josephmarlin/Feline-Sustenance-Amplifier/CatFeeder.pdf

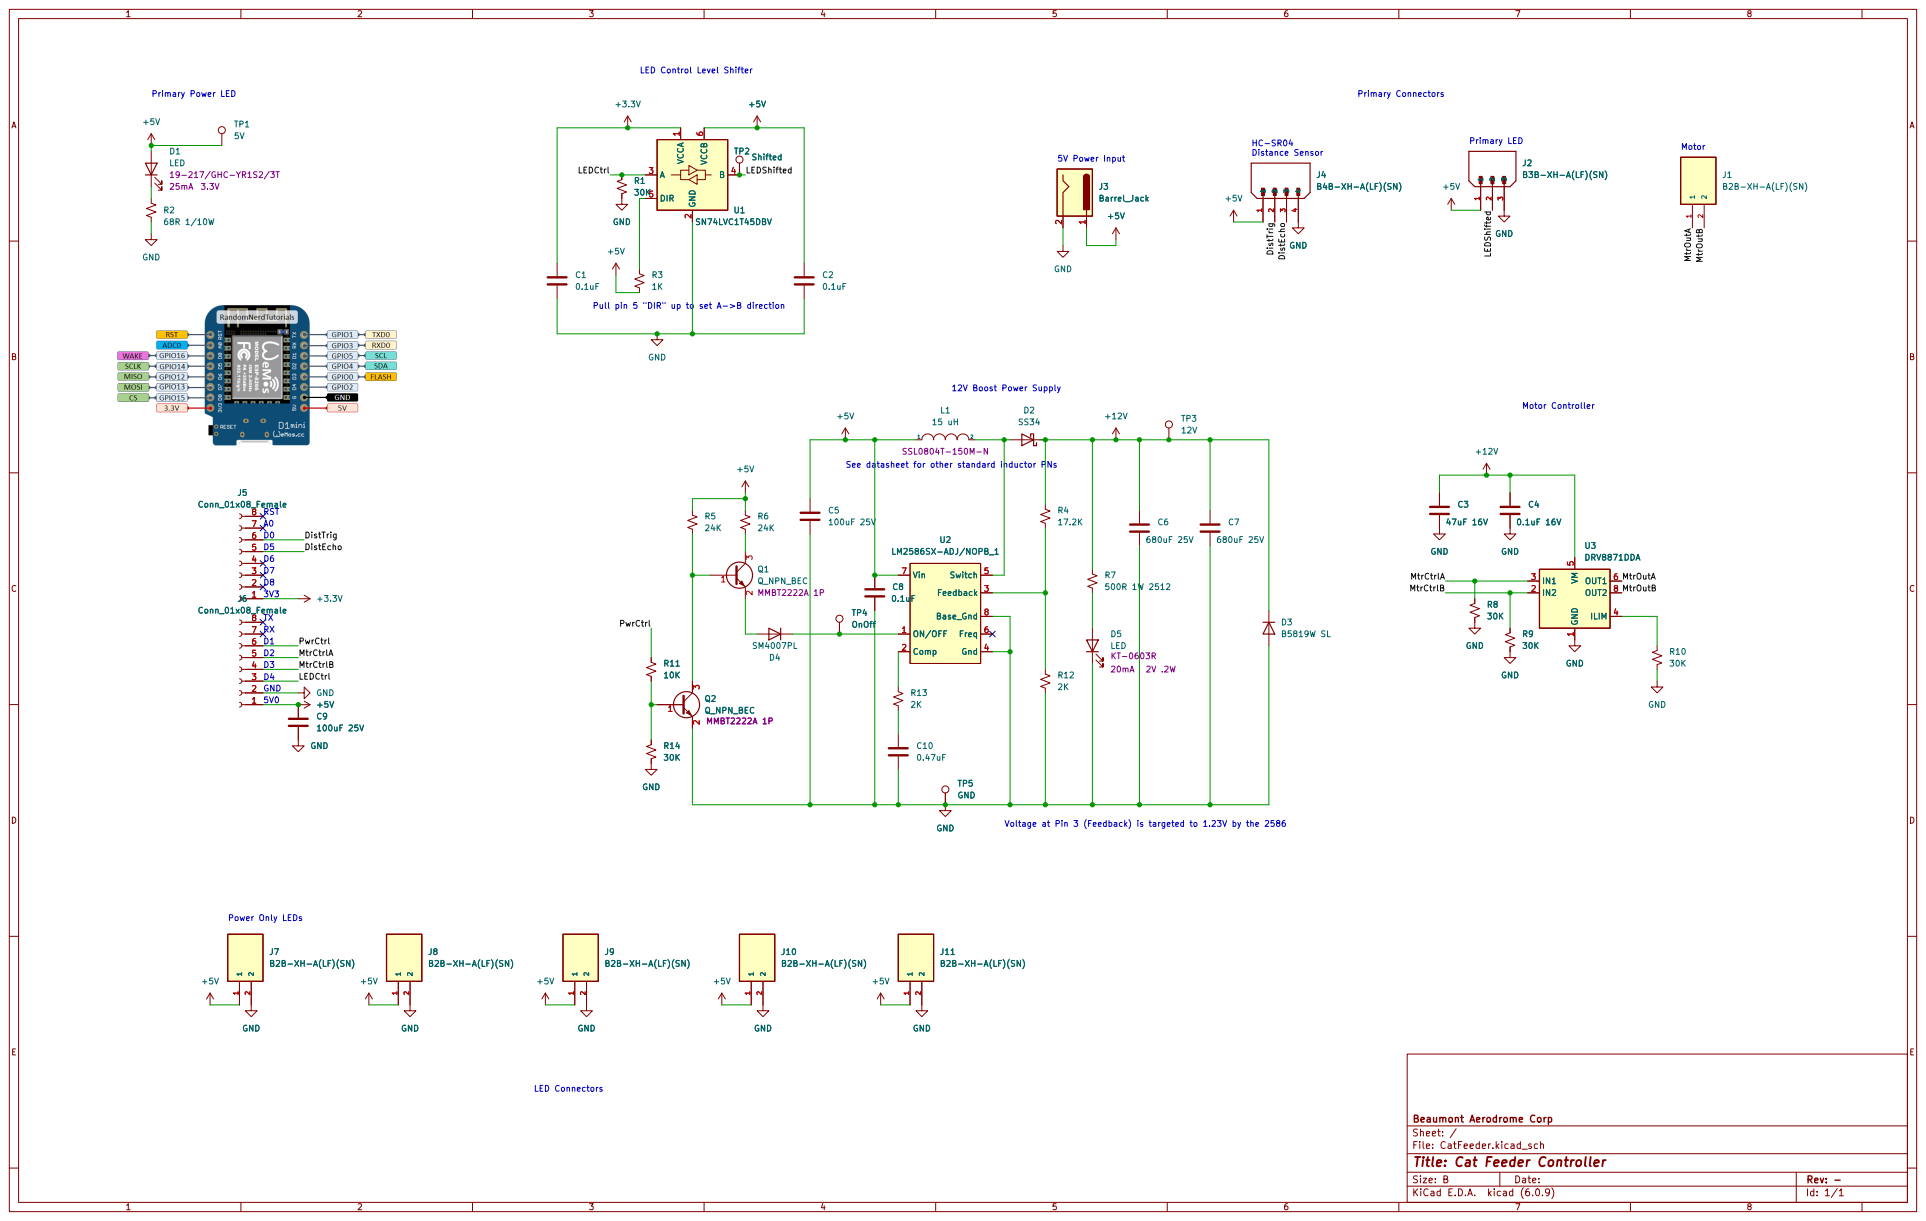
[picture p1: page 1]

Pull pin 5 "DIR" up to set A->B direction

2 J8B2B-XH-A(LF)(SN) D3B5819W SL GND GND

2 J11B2B-XH-A(LF)(SN) GND

Voltage at Pin 3 (Feedback) is targeted to 1.23V by the 2586

LED Connectors Power Only LEDs

File: CatFeeder.kicad_sch Sheet: / Beaumont Aerodrome Corp

Id: 1/1 Title: Cat Feeder Controller
