josephmarlin/Feline-Sustenance-Amplifier/CatFeeder.kicad_pcb

## KiCad design CatFeeder.kicad_pcb (2023-03-10)

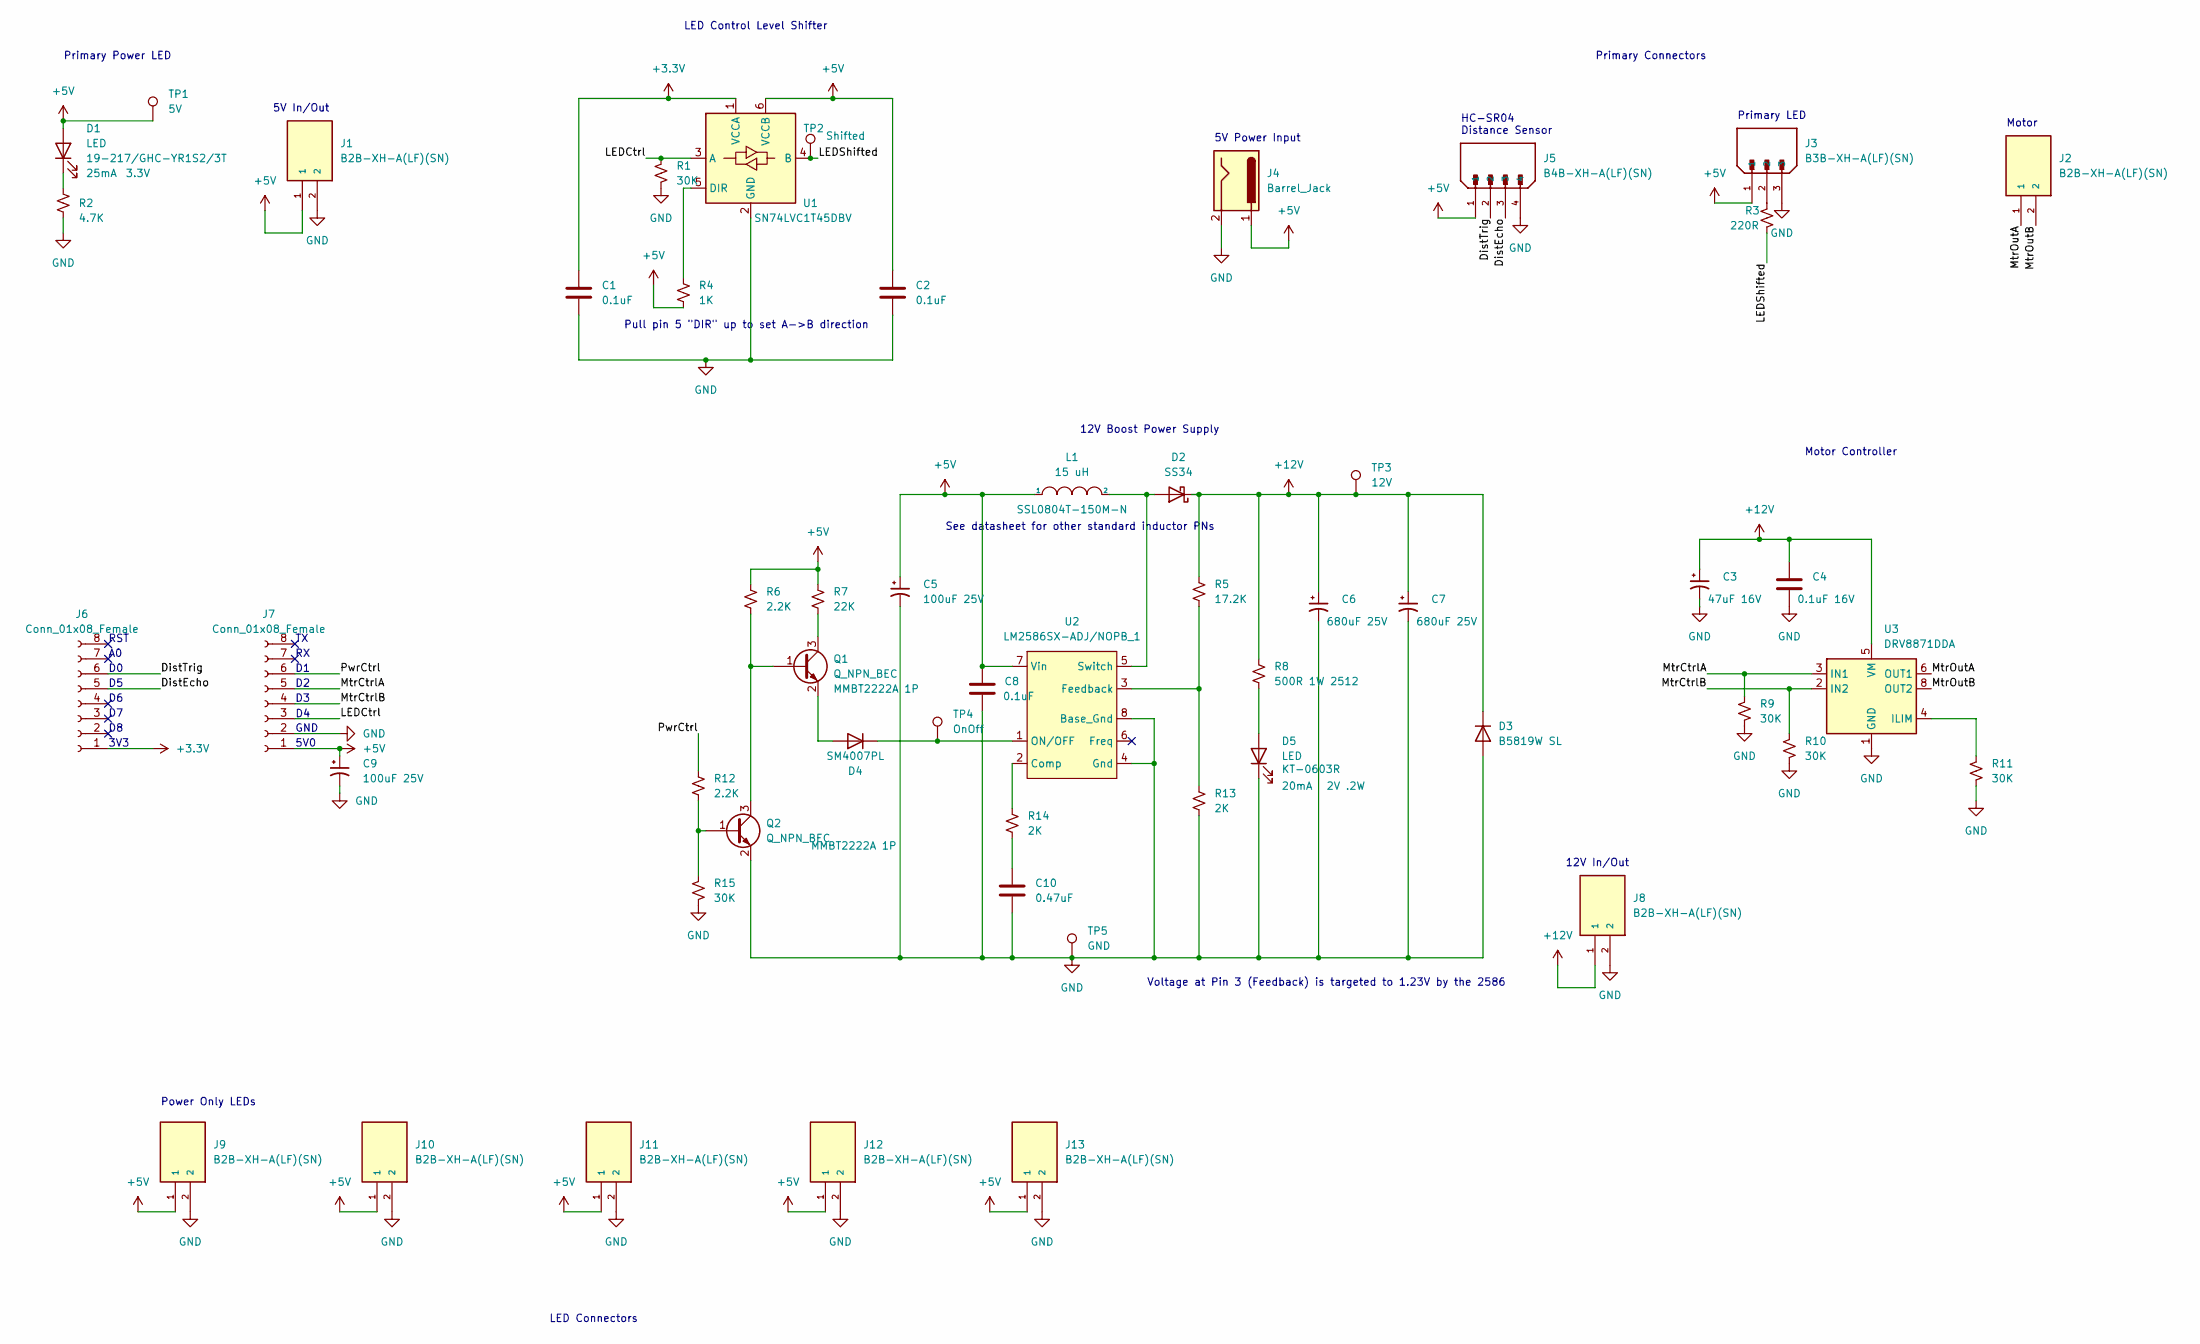
[picture p2: schematic CatFeeder.kicad_sch, Cat Feeder Controller]

Parts:
C1, C2, C8: 0.1uF; C_0402_1005Metric
C3: 47uF 16V; CP_Elec_5x5.4
C4: 0.1uF 16V; C_0402_1005Metric
C5, C9: 100uF 25V; CP_Radial_D8.0mm_P3.50mm
C6, C7: 680uF 25V; CP_Radial_D8.0mm_P3.50mm
C10: 0.47uF; C_0603_1608Metric
D1: LED; LED_0603_1608Metric; Voltage 3.3V
D2: SS34; D_SMA
D3: B5819W SL; D_SOD-123
D4: SM4007PL; D_SOD-123F
D5: LED; LED_0603_1608Metric; Voltage 2V .2W
J1, J2, J8, J9, J10, J11, J12, J13: B2B-XH-A(LF)(SN); JST_XH_B2B-XH-A_1x02_P2.50mm_Vertical
J3: B3B-XH-A(LF)(SN); JST_XH_B3B-XH-A_1x03_P2.50mm_Vertical; PARTREV N/A
J4: Barrel_Jack; BarrelJack_CUI_PJ-063AH_Horizontal
J5: B4B-XH-A(LF)(SN); JST_XH_B4B-XH-A_1x04_P2.50mm_Vertical; PARTREV N/A
J6, J7: Conn_01x08_Female; PinSocket_1x08_P2.54mm_Vertical
L1: 15 uH; SSL0804_Inductor_SMD
Q1, Q2: Q_NPN_BEC; SOT-23
R1, R9, R10, R11, R15: 30K; R_0402_1005Metric
R2: 4.7K; R_0805_2012Metric
R3: 220R; R_0805_2012Metric
R4: 1K; R_0402_1005Metric
R5: 17.2K; R_0603_1608Metric
R6, R12: 2.2K; R_0805_2012Metric
R7: 22K; R_0805_2012Metric
R8: 500R 1W 2512; R_2512_6332Metric
R13, R14: 2K; R_0402_1005Metric
TP1: 5V; TestPoint_Pad_D1.5mm
TP2: Shifted; TestPoint_Pad_D1.5mm
TP3: 12V; TestPoint_Pad_D1.5mm
TP4: OnOff; TestPoint_Pad_D1.0mm
TP5: GND; TestPoint_Pad_D1.5mm
U1: SN74LVC1T45DBV; SOT-23-6
U2: LM2586SX-ADJ/NOPB_1; TO-263-7_TabPin8
U3: DRV8871DDA; Texas_HTSOP-8-1EP_3.9x4.9mm_P1.27mm_EP2.95x4.9mm_Mask2.4x3.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

Connections:
+3.3V: C1.1, J6.1, U1.1 (VCCA)
+5V: C2.1, C5.1, C8.1, C9.1, D1.2 (A), J1.1, J3.1, J4.1, J5.1, J7.1, J9.1, J10.1, J11.1, J12.1, J13.1, L1.1, R4.2, R6.1, R7.1, TP1.1, U1.6 (VCCB), U2.7 (Vin)
+12V: C3.1, C4.1, C6.1, C7.1, D2.1 (K), D3.2 (K), J8.1, R5.1, R8.1, TP3.1, U3.5 (VM)
/DistEcho: J5.3, J6.5
/DistTrig: J5.2, J6.6
/LEDCtrl: J7.3, R1.1, U1.3 (A)
/LEDShifted: R3.2, TP2.1, U1.4 (B)
/MtrCtrlA: J7.5, R9.1, U3.3 (IN1)
/MtrCtrlB: J7.4, R10.1, U3.2 (IN2)
/MtrOutA: J2.1, U3.6 (OUT1)
/MtrOutB: J2.2, U3.8 (OUT2)
/PwrCtrl: J7.6, R12.1
GND: C1.2, C2.2, C3.2, C4.2, C5.2, C6.2, C7.2, C8.2, C9.2, C10.2, D3.1 (A), D5.1 (K), J1.2, J3.3, J4.2, J5.4, J7.2, J8.2, J9.2, J10.2, J11.2, J12.2, J13.2, Q2.2 (E), R1.2, R2.2, R9.2, R10.2, R11.2, R13.2, R15.2, TP5.1, U1.2 (GND), U2.4 (Gnd), U2.8 (Base_Gnd), U3.1 (GND), U3.7 (GND), U3.9 (GND)
unnamed: C10.1, R14.2
unnamed: D1.1 (K), R2.1
unnamed: D2.2 (A), L1.2, U2.5 (Switch)
unnamed: D4.1 (K), TP4.1, U2.1 (ON/OFF)
unnamed: D4.2 (A), Q1.2 (E)
unnamed: D5.2 (A), R8.2
unnamed: J3.2, R3.1
unnamed: Q1.1 (B), Q2.3 (C), R6.2
unnamed: Q1.3 (C), R7.2
unnamed: Q2.1 (B), R12.2, R15.1
unnamed: R4.1, U1.5 (DIR)
unnamed: R11.1, U3.4 (ILIM)
unnamed: R5.2, R13.1, U2.3 (Feedback)
unnamed: R14.1, U2.2 (Comp)

Notes on the sheet:
HC-SR04 Distance Sensor
5V0
Voltage at Pin 3 (Feedback) is targeted to 1.23V by the 2586
Motor
Primary LED
Power Only LEDs
Primary Power LED
Motor Controller
5V In/Out
5V Power Input
RST
LED Control Level Shifter
Pull pin 5 "DIR" up to set A->B direction
Primary Connectors
12V Boost Power Supply
12V In/Out
3V3
GND
LED Connectors
See datasheet for other standard inductor PNs

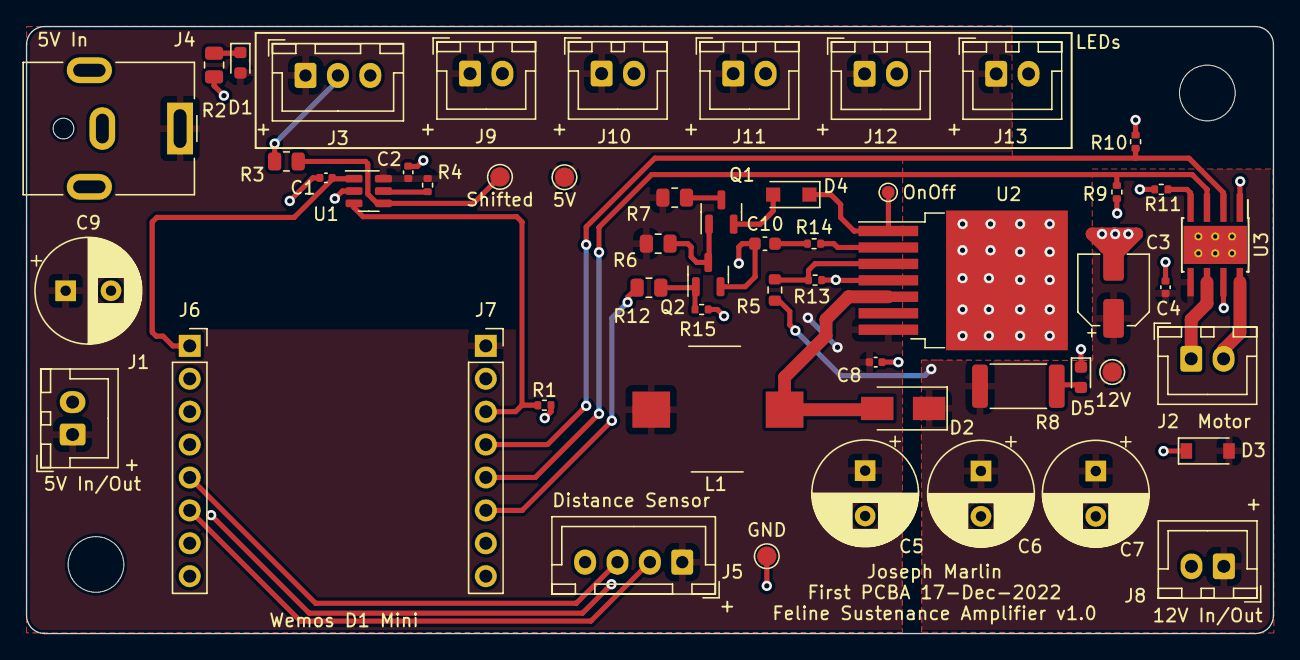
[picture p3: board CatFeeder.kicad_pcb from above]

Board: 2 copper layers, 96.3 x 46.9 mm, 54 parts (0 on the bottom side), 27 nets.
