josephmarlin/Feline-Sustenance-Amplifier/(commit log)

2022-12-05 ignore the auto-save file
    [CatFeeder.kicad_sch]
2022-12-13 Added power plane to top layer, fixed some layout errors
    [CatFeeder.csv, CatFeeder.kicad_pcb, CatFeeder.kicad_sch]
2022-12-14 Add pull ups to signals, tweak layout, reduce board size, add mounting holes
    [CatFeeder.kicad_pcb, CatFeeder.kicad_sch]
2022-12-19 added series resistor for neopixel control line, layout improvements, changed suspect resistors to 0805 for easier future rework
    [CatFeeder.kicad_pcb, CatFeeder.kicad_sch]
2022-12-19 rounded corners, added polarity silkscreen, dimmed the main power LED, fixed polarized cap schematic symbols.
    [CatFeeder.kicad_pcb, CatFeeder.kicad_sch]
2022-12-23 Manufacturing outputs
    [CatFeeder-B_Cu.gbl, CatFeeder-B_Mask.gbs, CatFeeder-B_Paste.gbp, CatFeeder-B_Silkscreen.gbo, CatFeeder-Edge_Cuts.gm1, CatFeeder-F_Cu.gtl, CatFeeder-F_Mask.gts, CatFeeder-F_Paste.gtp]
2023-03-10 final revision, as fabricated
    [CatFeeder.kicad_pcb, CatFeeder.kicad_sch]
2023-03-10 Add basic driver code
